Taugeshtu/Trackpad2040/Knowledge/Datasheets/nano_v2_pinout.png

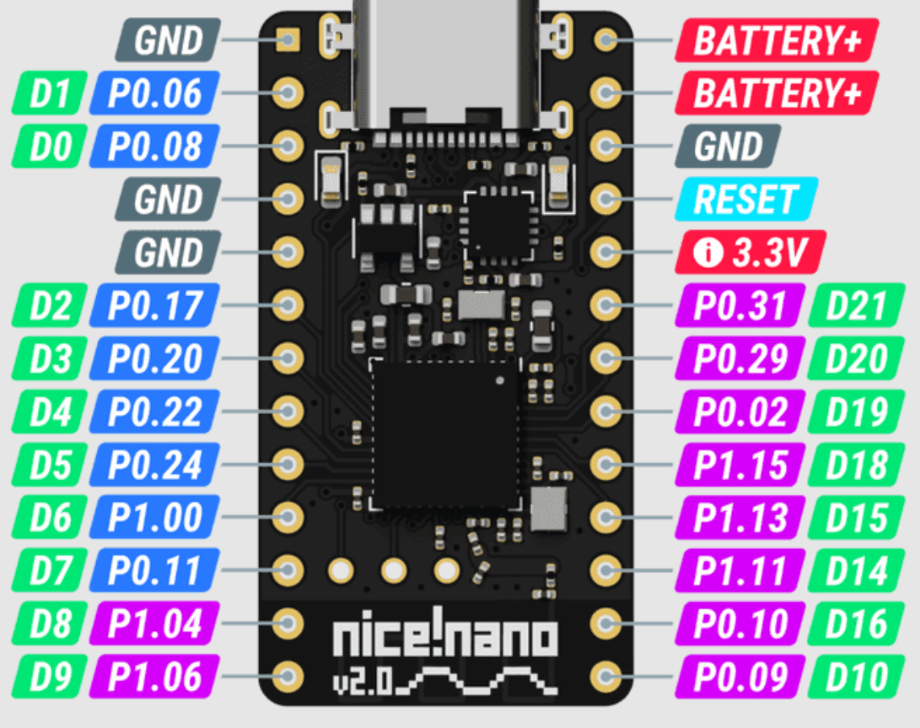
Knowledge/Datasheets/nano_v2_pinout.png
