Taugeshtu/Trackpad2040/Knowledge/Pics_Iteration1/Iter1_PCB_soldered.jpg

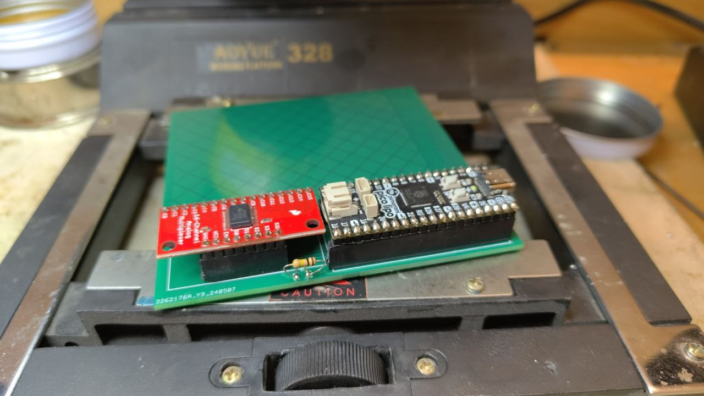
Knowledge/Pics_Iteration1/Iter1_PCB_soldered.jpg
