Taugeshtu/Trackpad2040/Knowledge/Tricks/Microsleeps.md

https://forums.raspberrypi.com/viewtopic.php?t=304922
includes us, sleep-by-nopping via asm, and discussion on how to do that properly with for() loops
