Taugeshtu/Trackpad2040/Knowledge/Tricks/Improving Pico's ADC.md

https://forums.raspberrypi.com/viewtopic.php?t=339289
