Taugeshtu/Trackpad2040/Knowledge/ADC_powering_Pico.png

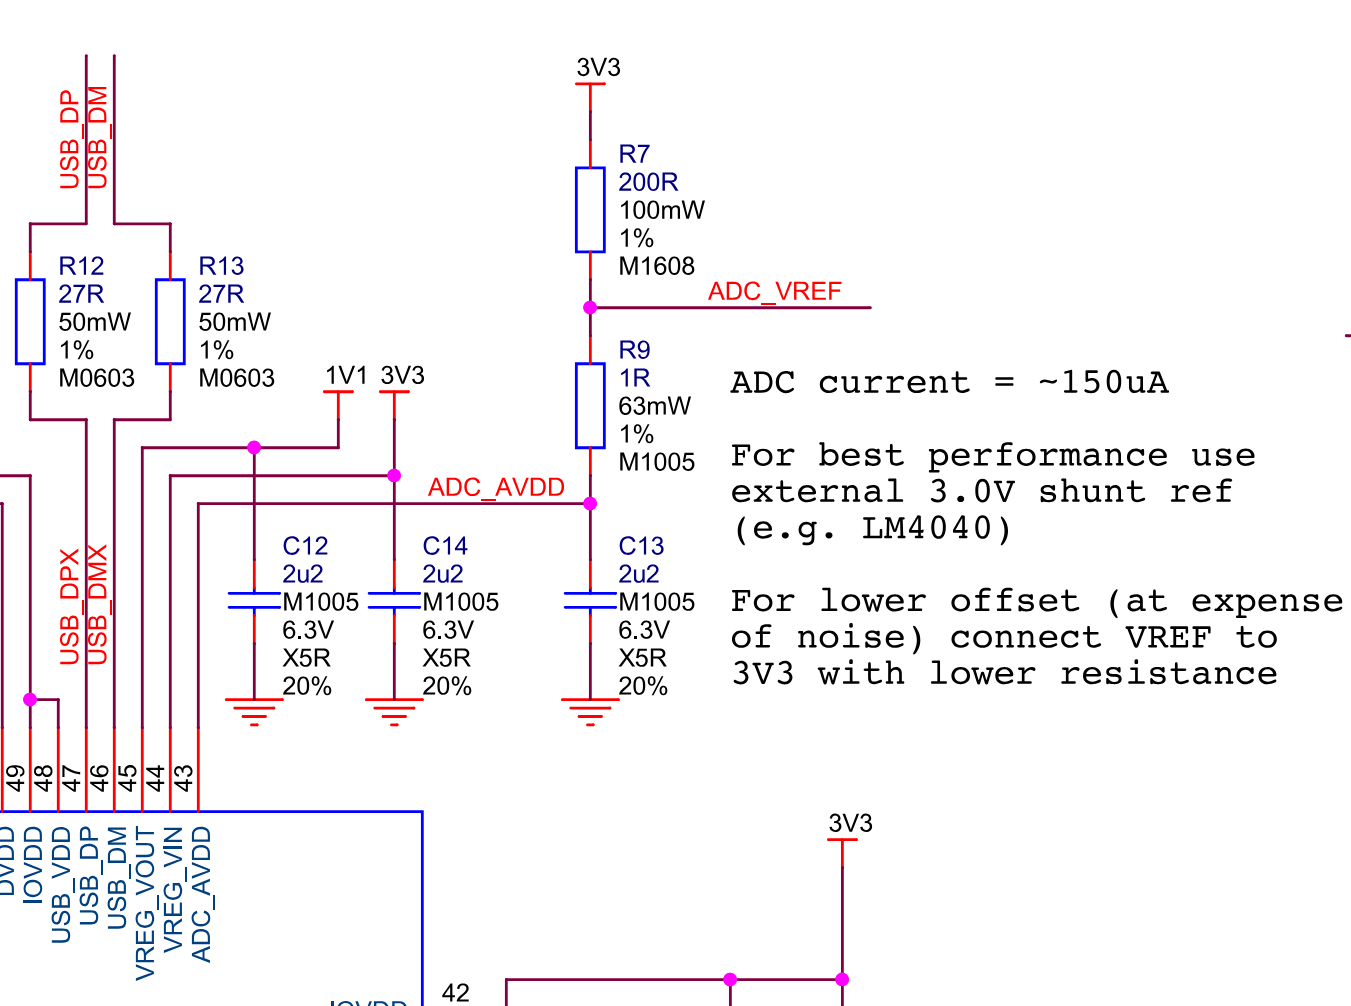
Knowledge/ADC_powering_Pico.png
