Taugeshtu/Trackpad2040/Knowledge/Pics_Iteration1/Iter1_MultiTouch.jpg

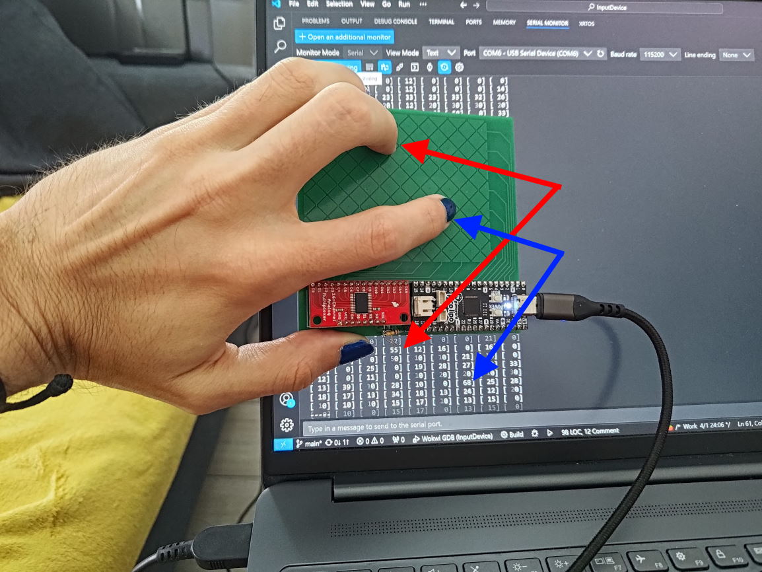
Knowledge/Pics_Iteration1/Iter1_MultiTouch.jpg
