Taugeshtu/Trackpad2040/Knowledge/Pics_Iteration1/Iter1_PCB.png

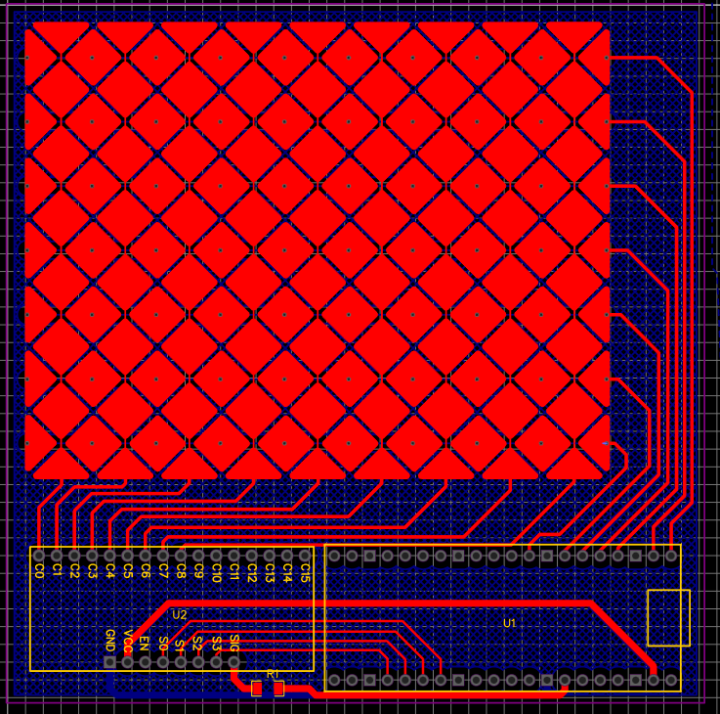
Knowledge/Pics_Iteration1/Iter1_PCB.png
