Taugeshtu/Trackpad2040/Knowledge/Pics_Iteration1/Iter1_Touch.jpg

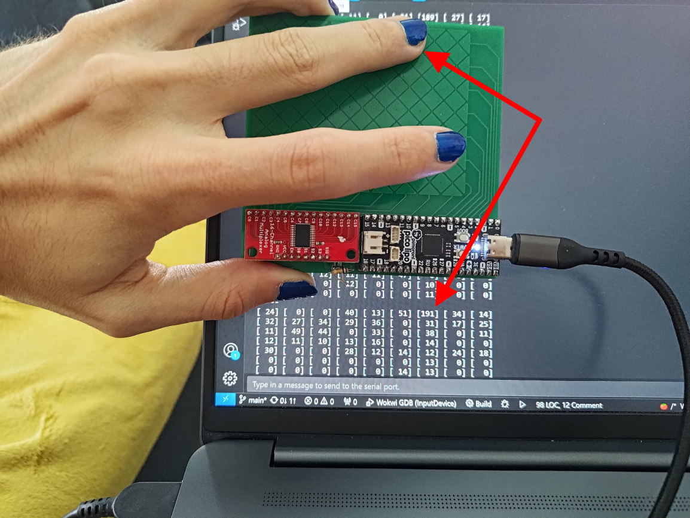
Knowledge/Pics_Iteration1/Iter1_Touch.jpg
