Taugeshtu/Trackpad2040/Knowledge/RP2040_IO_pad.png

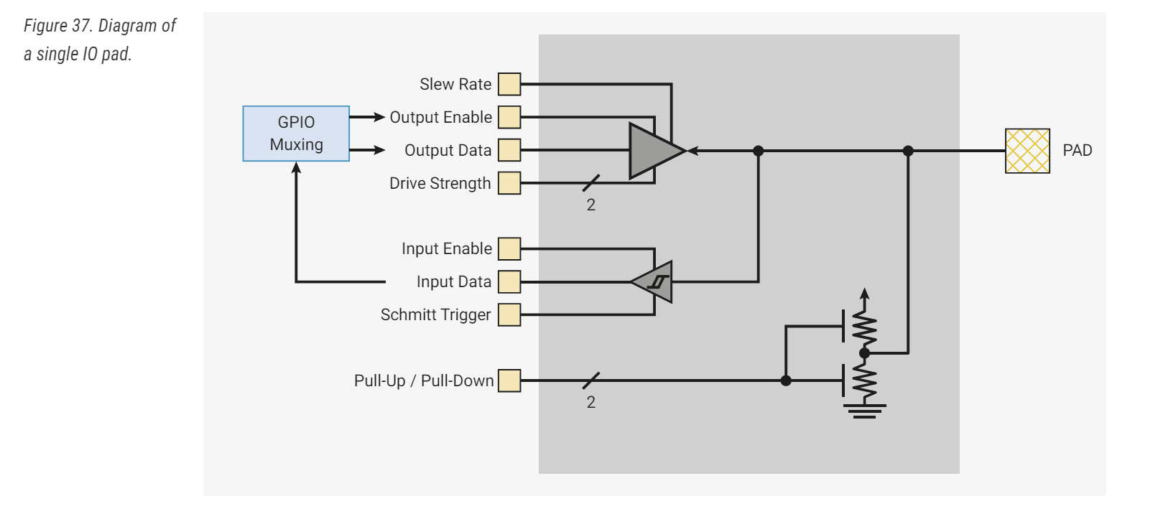
Knowledge/RP2040_IO_pad.png
