Taugeshtu/Trackpad2040/PCB/PCB_Trackpad2040_controller2.png

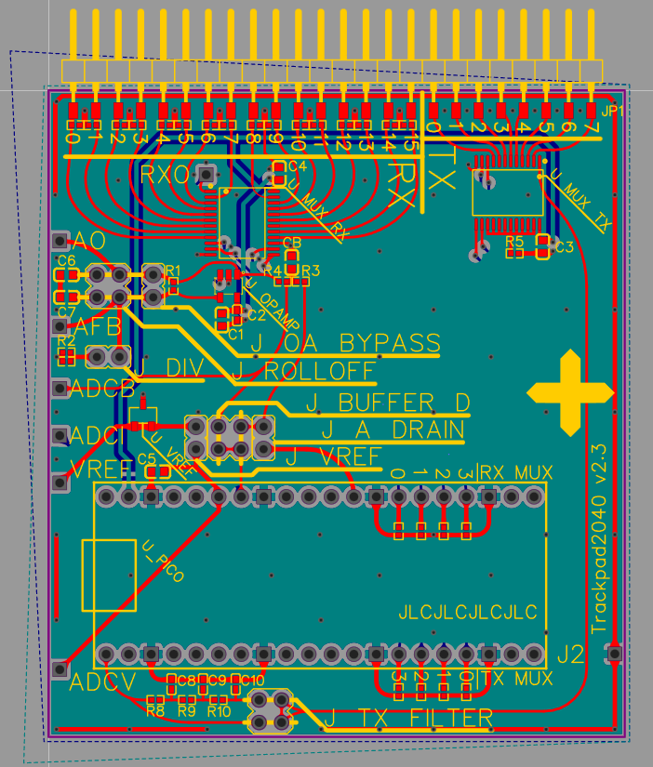
PCB/PCB_Trackpad2040_controller2.png
