Taugeshtu/Trackpad2040/PCB/PCB_Trackpad2040_controller.png

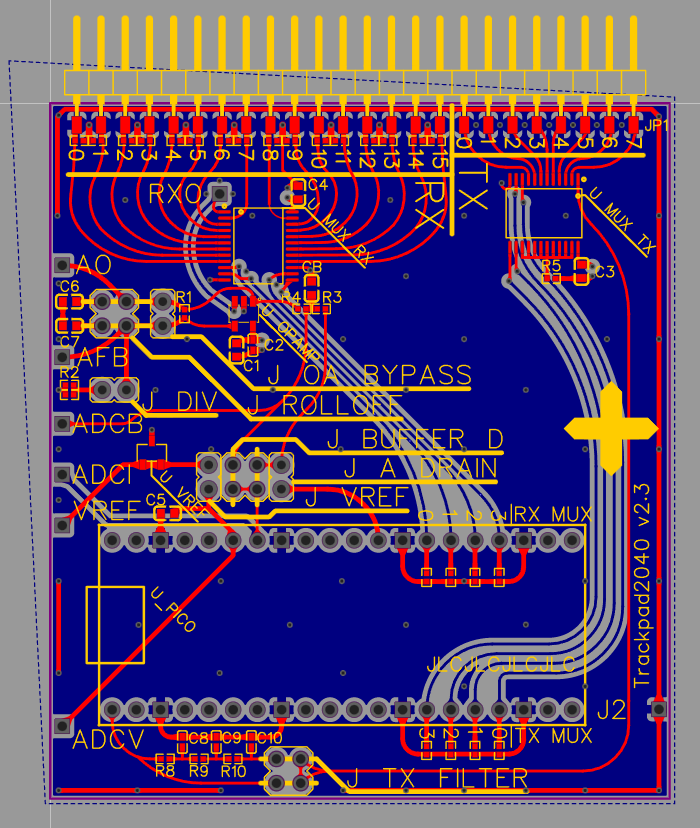
PCB/PCB_Trackpad2040_controller.png
