Taugeshtu/Trackpad2040/PCB/Schematic_Trackpad2040.png

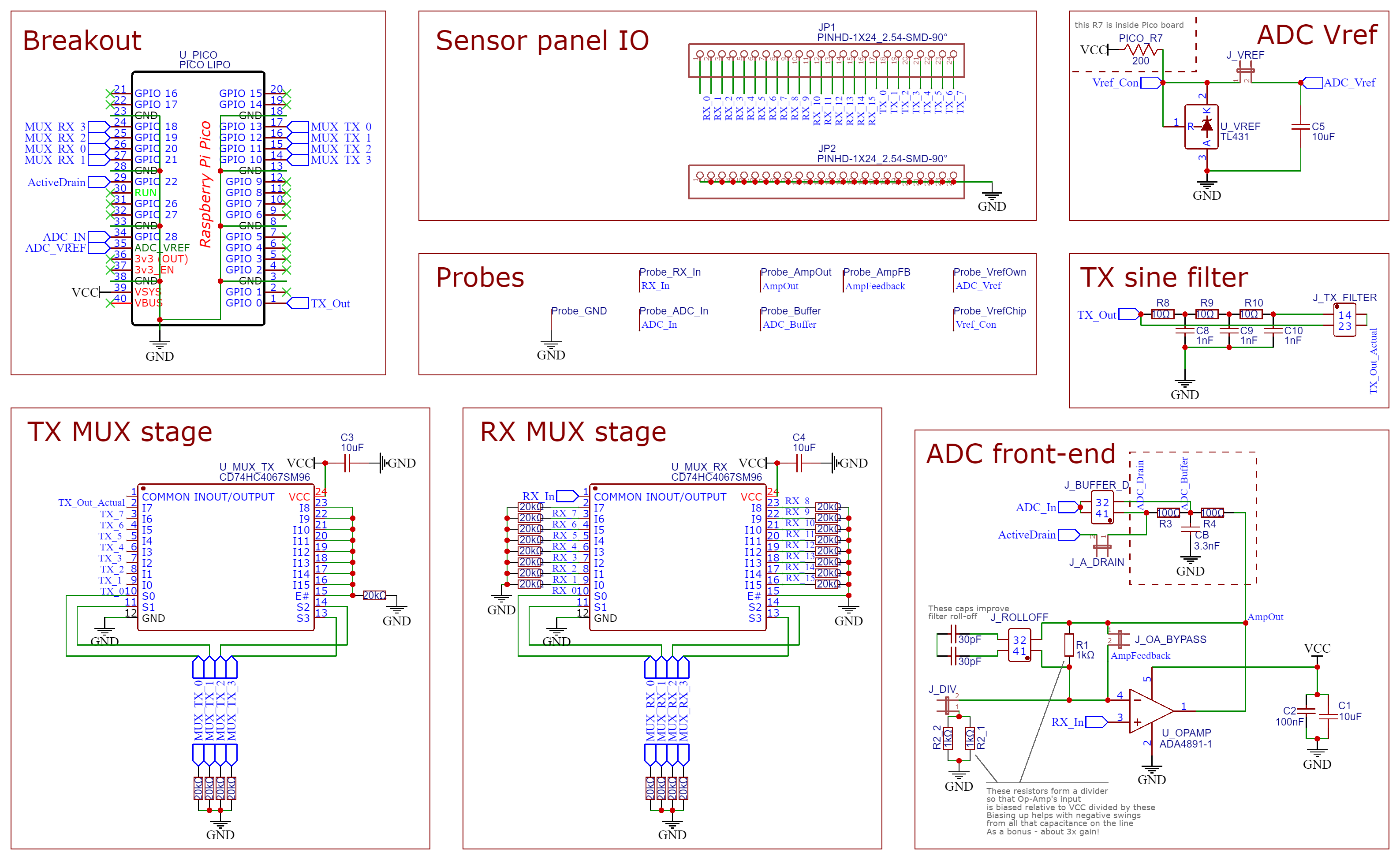
PCB/Schematic_Trackpad2040.png
