Taugeshtu/Trackpad2040/PCB/Fab/BOM_Trackpad2040_controller.csv

ID | Name | Designator | Footprint | Quantity | Manufacturer Part | Manufacturer | Supplier | Supplier Part | Price
1 | 20kΩ | RM_3,RM_2,R5,RM_4,RM_5,RM_6,RM_7,RX_0,RX_1,RX_2,RX_3,RX_4,RX_5,RX_6,RX_7,RX_8,RX_9,RX_10,RX_11,RX_12,RX_13,RX_14,RX_15,RM_1,RM_0 | R0402 | 25 | 0402WGF2002TCE | UNI-ROYAL(厚声) | LCSC | C25765 | 0.001
2 | 1nF | C10,C9,C8 | C0402 | 3 | 0402B102K500NT | FH(风华) | LCSC | C1523 | 0.001
3 | 10Ω | R8,R9,R10 | R0402 | 3 | 0402WGF100JTCE | UNI-ROYAL(厚声) | LCSC | C25077 | 0.001
4 | 10uF | C1,C3,C4,C5 | C0603 | 4 | CL10A106KP8NNNC | SAMSUNG(三星) | LCSC | C19702 | 0.005
5 | 100nF | C2 | C0402 | 1 | CL05B104KO5NNNC | SAMSUNG(三星) | LCSC | C1525 | 0.001
6 | 30pF | C6,C7 | C0603 | 2 | 0603CG300J500NT | FH(风华) | LCSC | C1658 | 0.003
7 | 3.3nF | CB | C0603 | 1 | CL10B332KB8NNNC | SAMSUNG(三星) | LCSC | C1613 | 0.005
8 | 1kΩ | R1,R2_1,R2_2 | R0402 | 3 | 0402WGF1001TCE | UNI-ROYAL(厚声) | LCSC | C11702 | 0.001
9 | 100Ω | R3,R4 | R0402 | 2 | 0402WGF1000TCE | UNI-ROYAL(厚声) | LCSC | C25076 | 0.001
10 | CD74HC4067SM96 | U_MUX_RX,U_MUX_TX | SSOP-24_L8.1-W5.3-P0.65-LS7.8-BL | 2 | CD74HC4067SM96 | TI(德州仪器) | LCSC | C98457 | 0.519
11 | ADA4891-1 | U_OPAMP | SOT-23-5_L3.0-W1.7-P0.95-LS2.8-BR | 1 | ADA4891-1ARJZ-R7 | ADI(亚德诺) | LCSC | C141926 | 0.701
12 | TL431 | U_VREF | SOT-23-3_L2.9-W1.6-P1.90-LS2.8-BR | 1 | CJ431 | CJ(江苏长电/长晶) | LCSC | C3113 | 0.032
