Taugeshtu/Trackpad2040/PCB/SensorMatrix_16x8_Step9mm.dxf

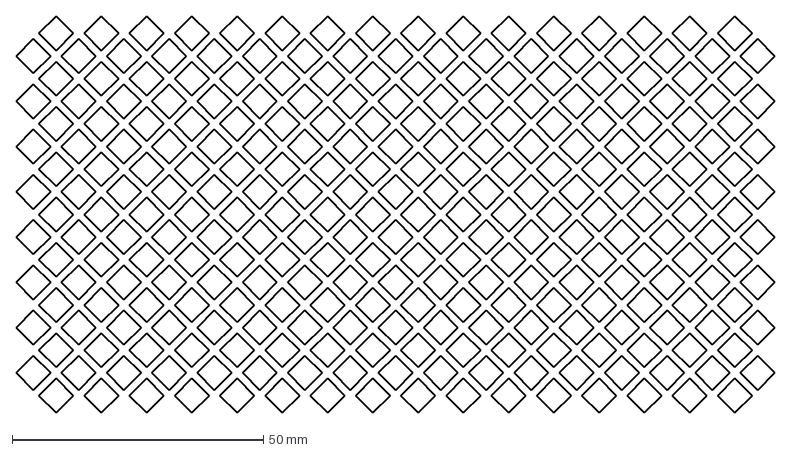
[picture p11: CAD file, 2024-06-19]
PCB/SensorMatrix_16x8_Step9mm.dxf
150.9 x 78.9 mm
