Taugeshtu/Trackpad2040/(list of files, drawings)

Other design files:
PCB/PCB_controller.json
PCB/PCB_sensor.json
