Taugeshtu/Trackpad2040/hello_tau.c

#include <stdio.h>
#include "pico/stdlib.h"
#include "hardware/gpio.h"
#include "hardware/pwm.h"
#include "hardware/adc.h"
#include "library.h"

#include "pico/multicore.h"
// Shared variable for the counter
volatile uint32_t cycle_counter = 0;


// Core 1 main function with inline assembly
void core1_main() {
	__asm volatile (
		"ldr r0, =cycle_counter\n"  // 2 cycles: Load the address of cycle_counter into r0
		"1:\n"                      // Loop label
		"ldr r1, [r0]\n"            // 2 cycles: Load the value of cycle_counter into r1
		"add r1, r1, #1\n"          // 1 cycle: Increment r1
		"str r1, [r0]\n"            // 2 cycles: Store the incremented value back to cycle_counter
		"b 1b\n"                    // 2 cycles: Branch back to loop label
	);
}

void _printDiff( uint8_t TXcount, uint8_t RXcount, uint16_t (*result)[RXcount], uint16_t (*initial)[RXcount], float conversionFactor ) {
	printf( "-----\n" );
	for( uint8_t i = 0; i < TXcount; i++ ) {
		for( uint8_t j = 0; j < RXcount; j++ ) {
			float convertedValue = result[i][j] *conversionFactor;
			float convertedInitial = initial[i][j] *conversionFactor;
			float x = convertedValue - convertedInitial;
			printf( "[%0.2f] ", x );
		}
		printf( "\n" );
	}
}

void _diff( uint8_t x, uint8_t y, uint16_t (*base)[y], uint16_t (*update)[y], int16_t (*result)[y] ) {
	for( uint8_t i = 0; i < x; i++ ) {
		for( uint8_t j = 0; j < y; j++ ) {
			int16_t diff = update[i][j] - base[i][j];
			if( diff < 0 ) diff = -diff;
			if( diff < 10 ) diff = 0;
			result[i][j] = diff;
		}
	}
}

void _printRawSigned( uint8_t x, uint8_t y, int16_t (*array)[y] ) {
	printf( "-----\n" );
	for( uint8_t i = 0; i < x; i++ ) {
		for( uint8_t j = 0; j < y; j++ ) {
			printf( "[%3d] ", array[i][j] );
		}
		printf( "\n" );
	}
}

void _printRaw( uint8_t TXcount, uint8_t RXcount, uint16_t (*result)[RXcount] ) {
	printf( "-----\n" );
	for( uint8_t i = 0; i < TXcount; i++ ) {
		for( uint8_t j = 0; j < RXcount; j++ ) {
			printf( "[%3d] ", result[i][j] );
		}
		printf( "\n" );
	}
}


__attribute__((optimize("O0"))) int main() {
	// Set CPU frequency to 100MHz
	set_sys_clock_khz( 100000, true );
	stdio_init_all();
	
	uint8_t TXpins[] = { 0, 1, 2, 3, 4, 5, 6 };
	// uint8_t TXpins[] = { 0, 1 };
	mt40TXresult TXsetup = mt40SetupTX( TXpins, sizeof( TXpins ) /sizeof( TXpins[0] ) );
	
	uint8_t MUXpins[] = { 21, 20, 19, 18 };
	uint8_t RXpin = 28;	// MUST be one of the ADC pins!
	mt40RXresult RXsetup = mt40SetupRXMUXed( MUXpins, sizeof( MUXpins ) /sizeof( MUXpins[0] ), RXpin );
	
	
	if( TXsetup.status != MT40_TX_STATUS_SUCCESS_25 ) {
		if( TXsetup.status == MT40_TX_STATUS_SUCCESS_50 ) {
			printf( "Setup half-successful - had to drop to 50 percent duty cycle" );
		}
		else {
			printf( "No dice, clock too slow!" );
			return 1;
		}
	}
	
	if( RXsetup.status != MT40_RX_STATUS_SUCCESS ) {
		if( RXsetup.status == MT40_RX_STATUS_ADC_PIN_ERROR ) {
			printf( "One of requested RX pins is not actually an ADC pin!" );
			return 1;
		}
	}
	
	uint8_t TXlinesCount = 7;
	uint8_t RXlinesCount = 9;
	uint16_t initial[TXlinesCount][RXlinesCount];
	const uint8_t initialScans = 1;
	for( uint8_t i = 0; i < initialScans; i++ ) {
		MT40_SCAN_STATUS initialScanStatus = mt40ScanMatrix( TXsetup.pins, RXsetup.pins, TXlinesCount, RXlinesCount, initial );
		if( initialScanStatus != MT40_SCAN_STATUS_OK ) {
			printf( "Scan failed :/" );
		}
		
		sleep_ms( 5 );
	}
	uint16_t result[TXlinesCount][RXlinesCount];
	int16_t diffed[TXlinesCount][RXlinesCount];
	
	while( 1 ) {
		MT40_SCAN_STATUS scanStatus = mt40ScanMatrix( TXsetup.pins, RXsetup.pins, TXlinesCount, RXlinesCount, result );
		if( scanStatus != MT40_SCAN_STATUS_OK ) {
			printf( "Scan failed :/" );
		}
		
		_diff( TXlinesCount, RXlinesCount, initial, result, diffed );
		_printRawSigned( TXlinesCount, RXlinesCount, diffed );
		
		const float conversionFactor = 3.3f /(1 << 12);
		// _printDiff( TXlinesCount, RXlinesCount, result, initial, conversionFactor );
		
		sleep_ms( 1000 );
	}
	
	return 0;
}
