Taugeshtu/Trackpad2040/(commit log)

2024-05-08 Imported initial code for 1 cell sensor
2024-05-08 EasyEDA project for the first iteration PCB
    [PCB_Multitouch_alaMTK.json]
2024-05-08 Knowledge expanded with MicroChip's sensor design guides
2024-05-14 Fixed the MUX pins order for correct selection
    [hello_tau.c]
2024-05-27 PCB for iteration 2
    [BOM_Trackpad2040.csv, PCB_Multitouch_alaMTK.json, PCB_Trackpad.json, PCB_controller.json, PickAndPlace_PCB_controller.csv]
2024-05-31 small PCB update
    [PCB_controller.json]
2024-06-15 Finishing touches on the PCB, iteration 1
    [PCB_Trackpad.json, PCB_Trackpad2040.json]
2024-06-17 PCB v2.2 - taking into account first round of feedback
    [BOM_Trackpad2040.csv, BOM_Trackpad2040_controller.csv, PCB_Trackpad2040.json, PickAndPlace_PCB_controller.csv, PickAndPlace_Trackpad2040_controller.csv]
2024-06-18 Controller PCB version 2.3 - TX goes via MUX and has an optiona sine-ish filter
    [PCB_Trackpad2040.json, PCB_controller.json]
2024-06-18 Updated Fab files
    [BOM_Trackpad2040_controller.csv, PickAndPlace_Trackpad2040_controller.csv]
2024-06-18 Nicer curves + teardrops
    [PCB_controller.json]
2024-06-18 Final fixes - made RX MUX pins into sensical order again, placed backing GND vias closer, made the board conform to JLC04161H-7628 controlled impedance stackup with 0.3mm traces
    [BOM_Trackpad2040_controller.csv, PCB_controller.json, PickAndPlace_Trackpad2040_controller.csv]
2024-06-19 Working on sensor PCB
    [PCB_sensor.json, SensorMatrix_16x8_Step9mm.dxf]
